cps-vip/robot-pcb/voltage_dividers.xlsx

Vout_max | 3 | V
Vin | 22 | V
R2 | 10000 | Ohm
R1 | 63333.33333 | Ohm
Vout_max | 3 | V
Vin | 5 | V
R2 | 10000 | Ohm
R1 | 6666.666667 | Ohm
Vout_max | 3 | V
Vin | 3.3 | V
R2 | 10000 | Ohm
R1 | 1000 | Ohm
R1 | 54900
R2 | 9310
Vin | 22
Vsense | 3.189845818
