cps-vip/robot-pcb/dcdc_eagle_3.3.kicad_sch

## KiCad design dcdc_eagle_3.3.kicad_sch (2026-04-16)

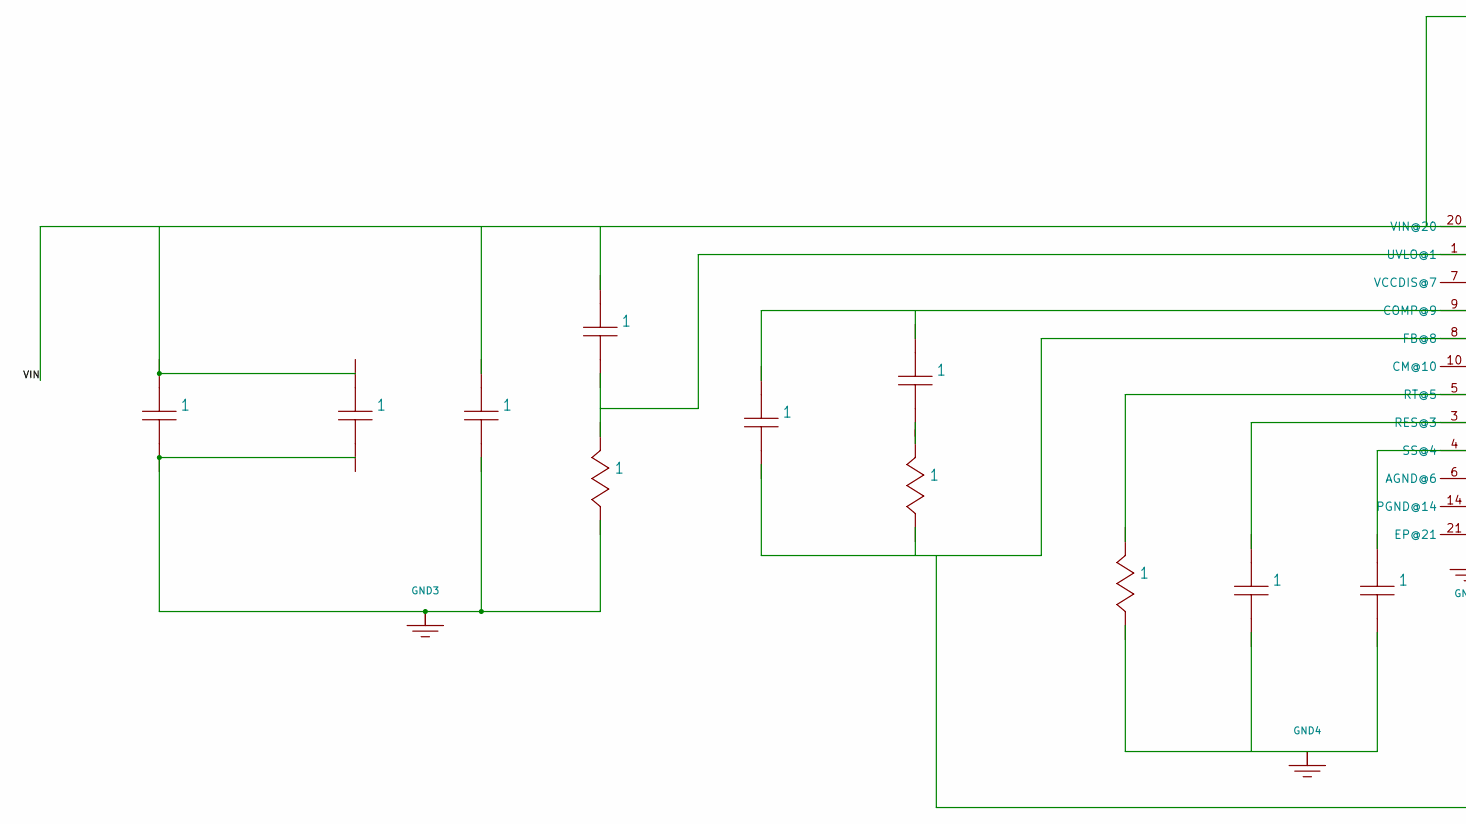
[picture p1: schematic dcdc_eagle_3.3.kicad_sch, part in row 1, column 1]

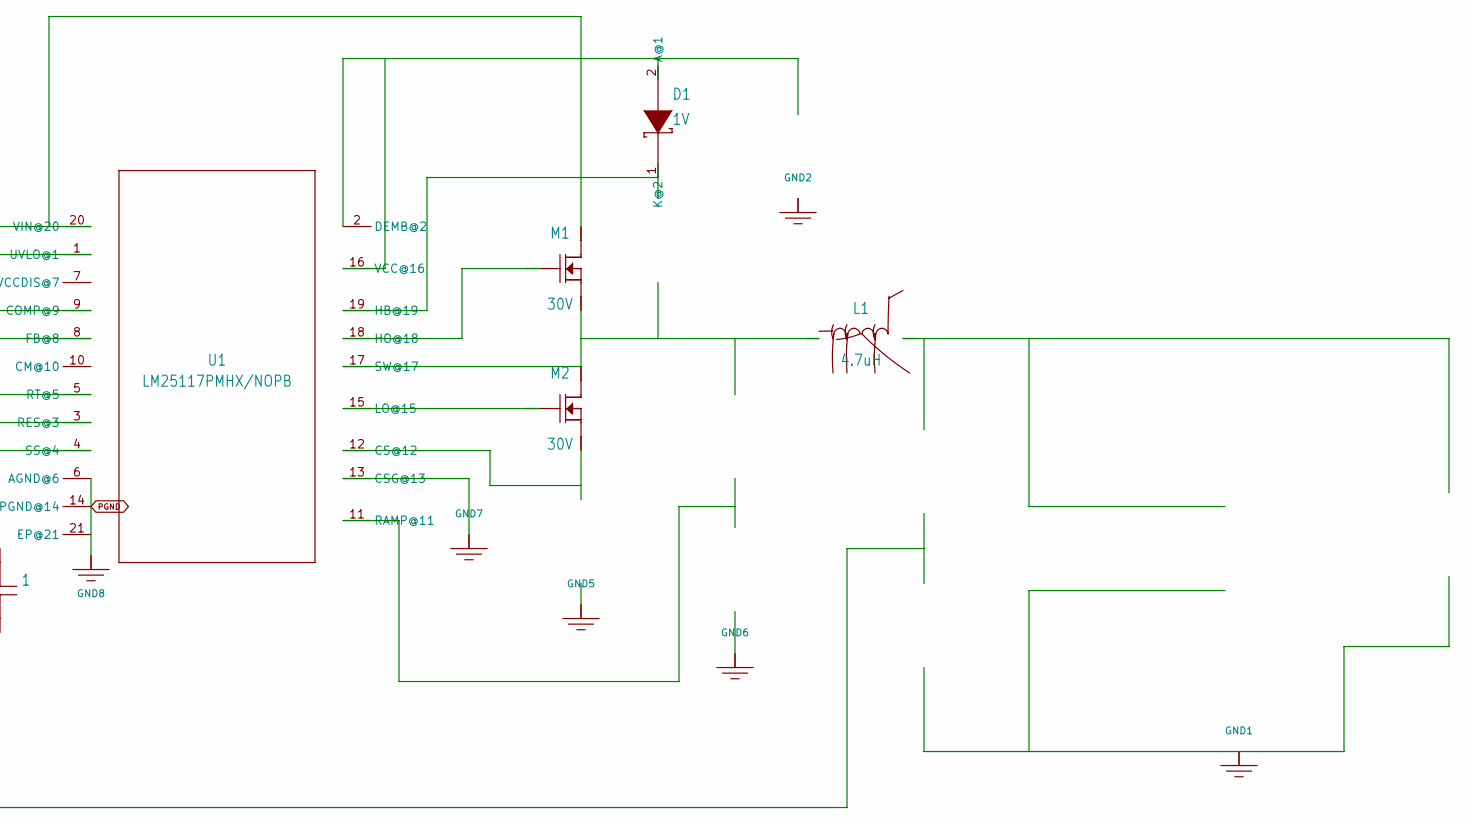
[picture p2: schematic dcdc_eagle_3.3.kicad_sch, part in row 1, column 2]

Parts:
1: 0805
D1: 1V; SOD-323
GND1, GND2, GND3, GND4, GND5, GND6, GND7, GND8: WB_GND
L1: 4.7uH; XAL6060
M1, M2: 30V; DQK0006C
U1: LM25117PMHX/NOPB; PWP0020A_N

Connections:
unnamed: 1.1 (1@1), 1.2 (2@2), U1.3 (RES@3), U1.4 (SS@4), U1.5 (RT@5), U1.9 (COMP@9)
unnamed: 1.2 (2@2), GND3.1, U1.8 (FB@8)
unnamed: GND7.1, U1.13 (CSG@13)
unnamed: M1.1 (Drain@1), M1.2 (Drain@2), M1.5 (Drain@3), M1.6 (Drain@4)
unnamed: M1.3 (Gate@5), U1.18 (HO@18)
unnamed: M1.4 (Source@6), M2.1 (Drain@1), M2.2 (Drain@2), M2.5 (Drain@3), M2.6 (Drain@4), U1.17 (SW@17)
unnamed: M2.3 (Gate@5), U1.15 (LO@15)
PGND: GND8.1, U1.6 (AGND@6), U1.14 (PGND@14)
VIN: U1.20 (VIN@20)
