cps-vip/robot-pcb/dcdc_reg.kicad_sch

## KiCad design dcdc_reg.kicad_sch (2026-05-31)

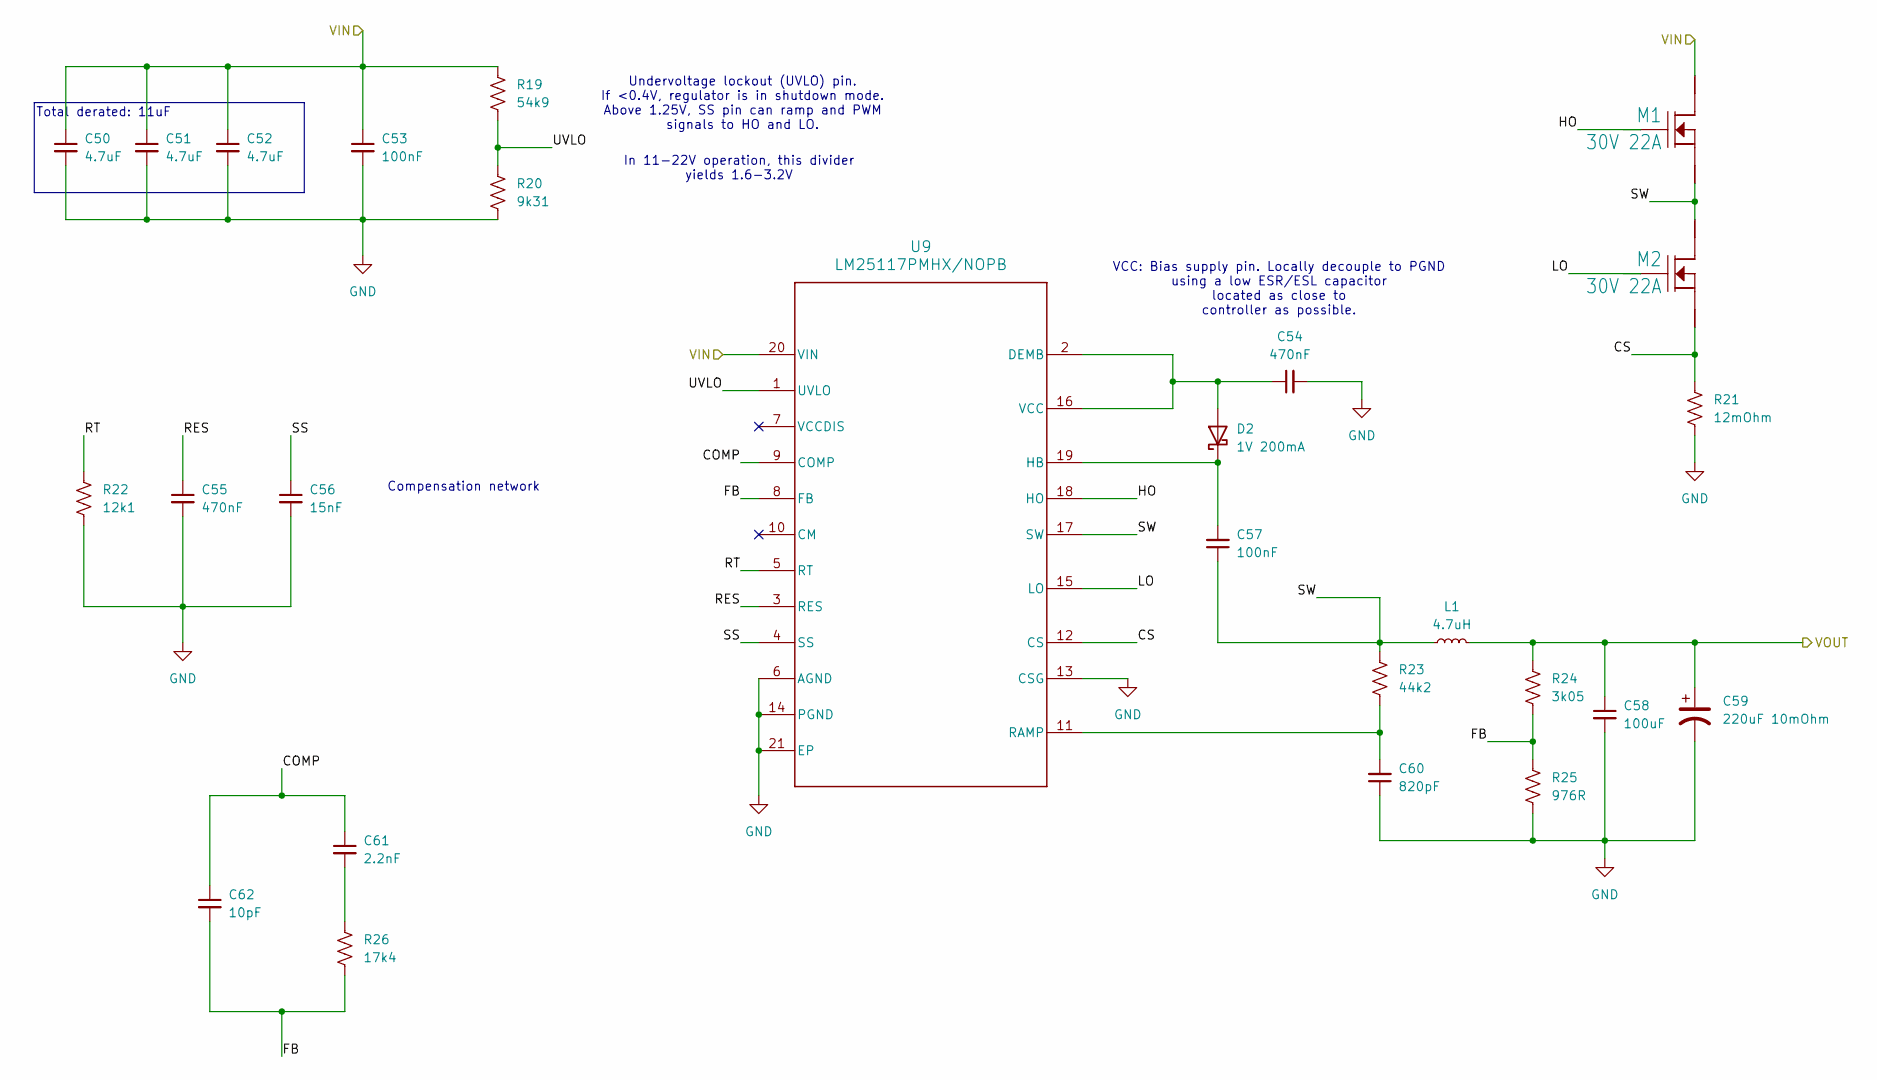
[picture p3: schematic dcdc_reg.kicad_sch]

Parts:
C50, C51, C52: 4.7uF
C53, C57: 100nF
C54, C55: 470nF
C56: 15nF
C58: 100uF
C59: 220uF 10mOhm
C60: 820pF
C61: 2.2nF
C62: 10pF
D2: 1V 200mA
L1: 4.7uH
M1, M2: 30V 22A; DQK0006C
R19: 54k9
R20: 9k31
R21: 12mOhm
R22: 12k1
R23: 44k2
R24: 3k05
R25: 976R
R26: 17k4
U9: LM25117PMHX/NOPB; PWP0020A_N

Connections:
COMP: C61.1, C62.1, U9.9 (COMP)
CS: M2.4 (Source@6), R21.1, U9.12 (CS)
FB: C62.2, R24.2, R25.1, R26.2, U9.8 (FB)
GND: C50.2, C51.2, C52.2, C53.2, C54.2, C55.2, C56.2, C58.2, C59.2, C60.1, R20.2, R21.2, R22.2, R25.2, U9.6 (AGND), U9.13 (CSG), U9.14 (PGND), U9.21 (EP)
HO: M1.3 (Gate@5), U9.18 (HO)
LO: M2.3 (Gate@5), U9.15 (LO)
unnamed: C54.1, D2.2 (A), U9.2 (DEMB), U9.16 (VCC)
unnamed: C57.2, D2.1 (K), U9.19 (HB)
unnamed: C60.2, R23.2, U9.11 (RAMP)
unnamed: C61.2, R26.1
RES: C55.1, U9.3 (RES)
RT: R22.1, U9.5 (RT)
SS: C56.1, U9.4 (SS)
SW: C57.1, L1.1, M1.4 (Source@6), M2.1 (Drain@1), M2.2 (Drain@2), M2.5 (Drain@3), M2.6 (Drain@4), R23.1, U9.17 (SW)
UVLO: R19.2, R20.1, U9.1 (UVLO)
VIN: C50.1, C51.1, C52.1, C53.1, M1.1 (Drain@1), M1.2 (Drain@2), M1.5 (Drain@3), M1.6 (Drain@4), R19.1, U9.20 (VIN)
VOUT: C58.1, C59.1, L1.2, R24.1

Notes on the sheet:
Compensation network
Undervoltage lockout (UVLO) pin. If <0.4V, regulator is in shutdown mode. Above 1.25V, SS pin can ramp and PWM signals to HO and LO.
VCC: Bias supply pin. Locally decouple to PGND using a low ESR/ESL capacitor located as close to controller as possible.
In 11-22V operation, this divider yields 1.6-3.2V
Total derated: 11uF
