cps-vip/robot-pcb/dcdc_reg_5v_6a.kicad_sch

## KiCad design dcdc_reg_5v_6a.kicad_sch (2026-05-31)

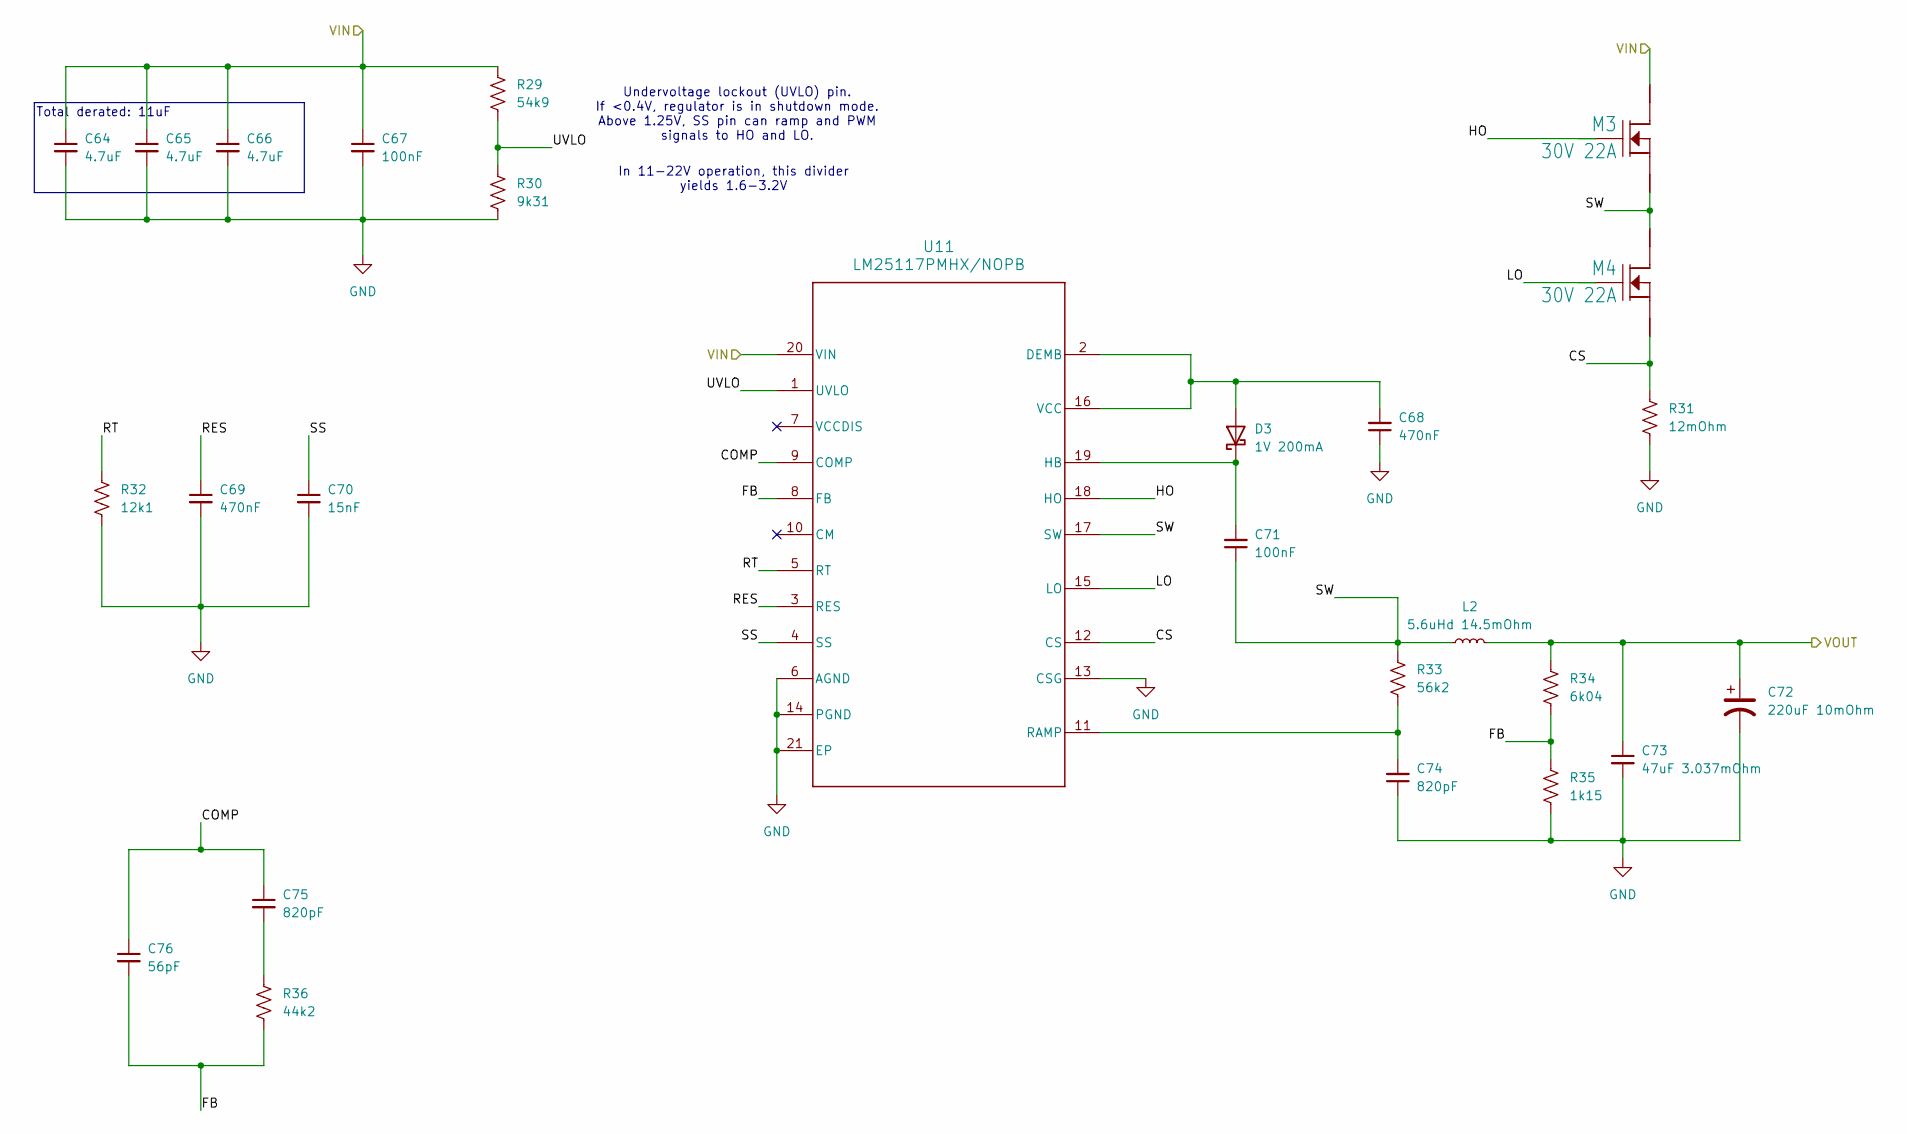
[picture p4: schematic dcdc_reg_5v_6a.kicad_sch]

Parts:
C64, C65, C66: 4.7uF
C67, C71: 100nF
C68, C69: 470nF
C70: 15nF
C72: 220uF 10mOhm
C73: 47uF 3.037mOhm
C74, C75: 820pF
C76: 56pF
D3: 1V 200mA
L2: 5.6uHd 14.5mOhm
M3, M4: 30V 22A; DQK0006C
R29: 54k9
R30: 9k31
R31: 12mOhm
R32: 12k1
R33: 56k2
R34: 6k04
R35: 1k15
R36: 44k2
U11: LM25117PMHX/NOPB; PWP0020A_N

Connections:
COMP: C75.1, C76.1, U11.9 (COMP)
CS: M4.4 (Source@6), R31.1, U11.12 (CS)
FB: C76.2, R34.2, R35.1, R36.2, U11.8 (FB)
GND: C64.2, C65.2, C66.2, C67.2, C68.1, C69.2, C70.2, C72.2, C73.2, C74.1, R30.2, R31.2, R32.2, R35.2, U11.6 (AGND), U11.13 (CSG), U11.14 (PGND), U11.21 (EP)
HO: M3.3 (Gate@5), U11.18 (HO)
LO: M4.3 (Gate@5), U11.15 (LO)
unnamed: C68.2, D3.2 (A), U11.2 (DEMB), U11.16 (VCC)
unnamed: C71.2, D3.1 (K), U11.19 (HB)
unnamed: C74.2, R33.2, U11.11 (RAMP)
unnamed: C75.2, R36.1
RES: C69.1, U11.3 (RES)
RT: R32.1, U11.5 (RT)
SS: C70.1, U11.4 (SS)
SW: C71.1, L2.1, M3.4 (Source@6), M4.1 (Drain@1), M4.2 (Drain@2), M4.5 (Drain@3), M4.6 (Drain@4), R33.1, U11.17 (SW)
UVLO: R29.2, R30.1, U11.1 (UVLO)
VIN: C64.1, C65.1, C66.1, C67.1, M3.1 (Drain@1), M3.2 (Drain@2), M3.5 (Drain@3), M3.6 (Drain@4), R29.1, U11.20 (VIN)
VOUT: C72.1, C73.1, L2.2, R34.1

Notes on the sheet:
Total derated: 11uF
In 11-22V operation, this divider yields 1.6-3.2V
Undervoltage lockout (UVLO) pin. If <0.4V, regulator is in shutdown mode. Above 1.25V, SS pin can ramp and PWM signals to HO and LO.
