cps-vip/robot-pcb/imu_module.kicad_sch

## KiCad design imu_module.kicad_sch (2026-04-16)

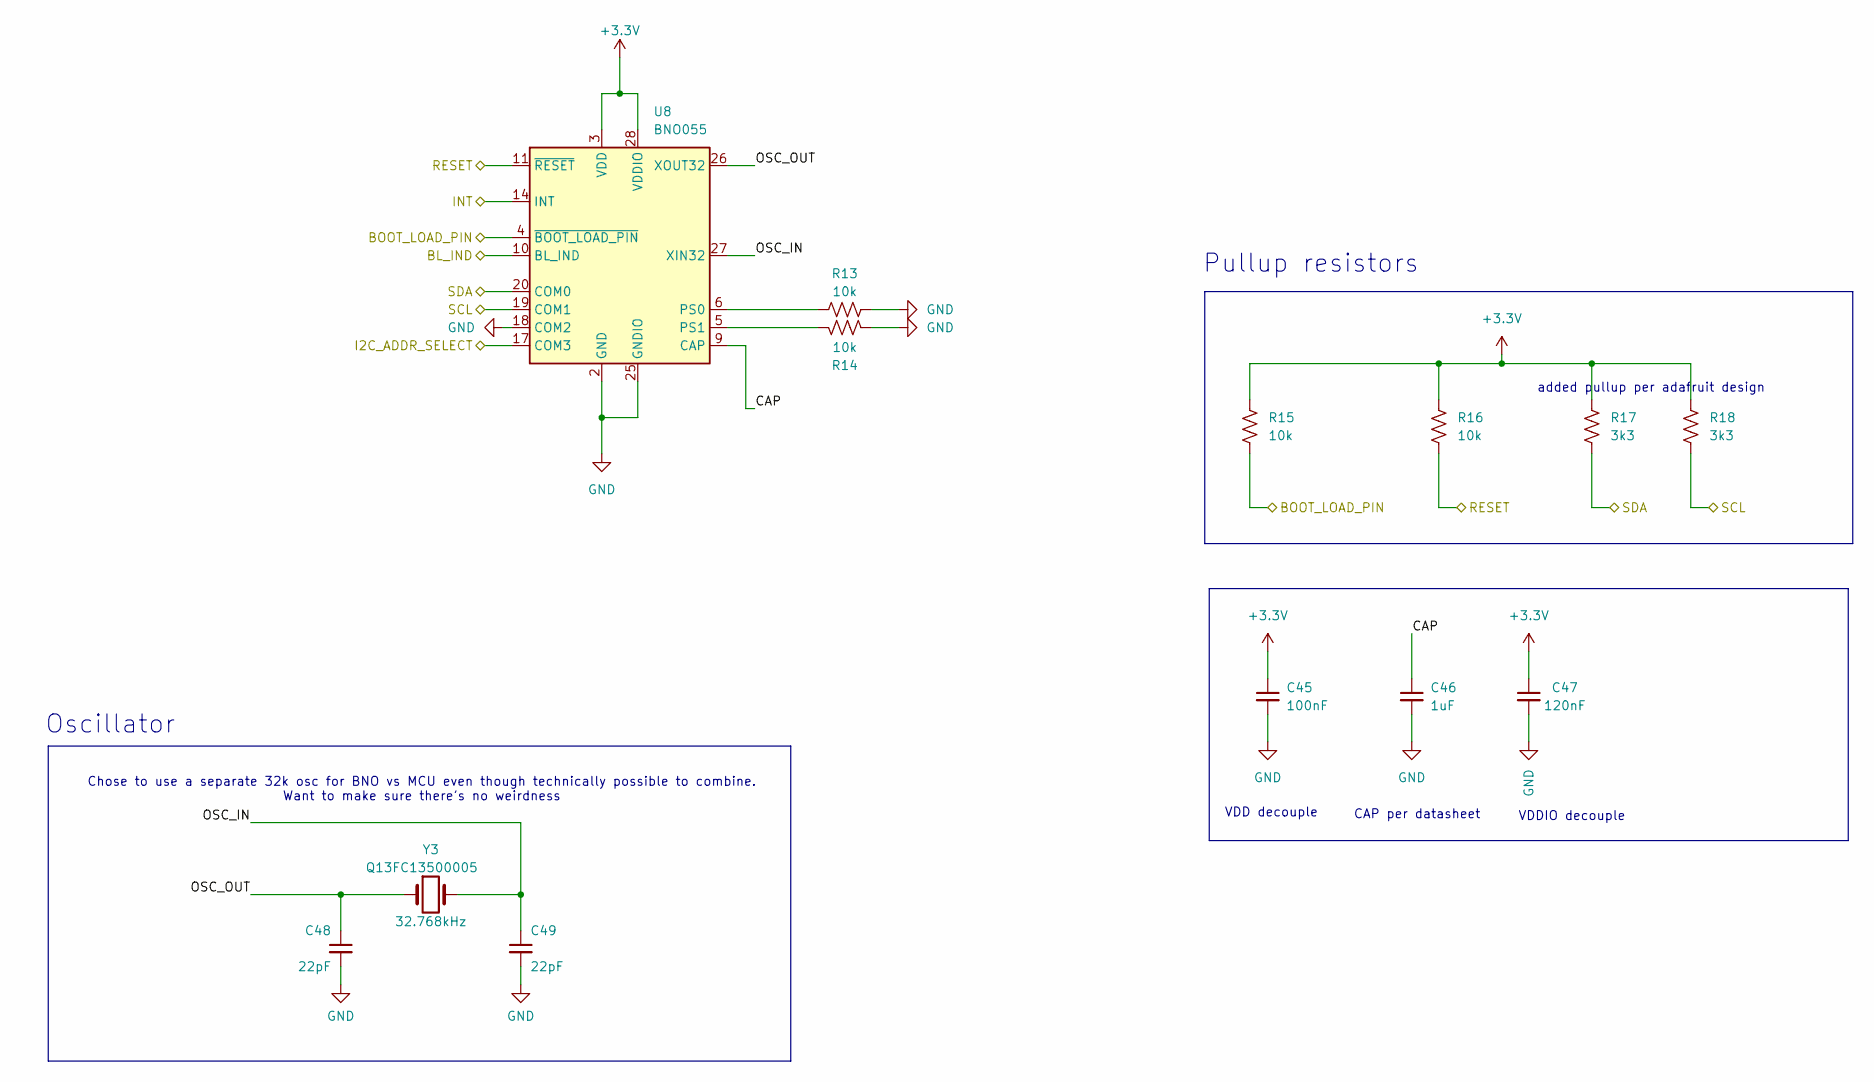
[picture p5: schematic imu_module.kicad_sch]

Parts:
C45: 100nF
C46: 1uF
C47: 120nF
C48, C49: 22pF; C_0402_1005Metric; LCSC C88877
R13, R14, R15, R16: 10k
R17, R18: 3k3
U8: BNO055; LGA-28_5.2x3.8mm_P0.5mm
Y3: Q13FC13500005; Crystal_SMD_3215-2Pin_3.2x1.5mm; LCSC C841881

Connections:
+3.3V: C45.1, C47.1, R15.1, R16.1, R17.1, R18.1, U8.3 (VDD), U8.28 (VDDIO)
BL_IND: U8.10 (BL_IND)
BOOT_LOAD_PIN: R15.2, U8.4 (~BOOT_LOAD_PIN)
CAP: C46.1, U8.9 (CAP)
GND: C45.2, C46.2, C47.2, C48.2, C49.2, R13.2, R14.2, U8.2 (GND), U8.18 (COM2), U8.25 (GNDIO)
I2C_ADDR_SELECT: U8.17 (COM3)
INT: U8.14 (INT)
unnamed: R13.1, U8.6 (PS0)
unnamed: R14.1, U8.5 (PS1)
OSC_IN: C49.1, U8.27 (XIN32), Y3.2
OSC_OUT: C48.1, U8.26 (XOUT32), Y3.1
RESET: R16.2, U8.11 (~RESET)
SCL: R18.2, U8.19 (COM1)
SDA: R17.2, U8.20 (COM0)

Notes on the sheet:
VDD decouple
Oscillator
VDDIO decouple
CAP per datasheet
added pullup per adafruit design
Pullup resistors
Chose to use a separate 32k osc for BNO vs MCU even though technically possible to combine. Want to make sure there's no weirdness
