cps-vip/robot-pcb/motor_driver.kicad_sch

## KiCad design motor_driver.kicad_sch (2026-05-31)

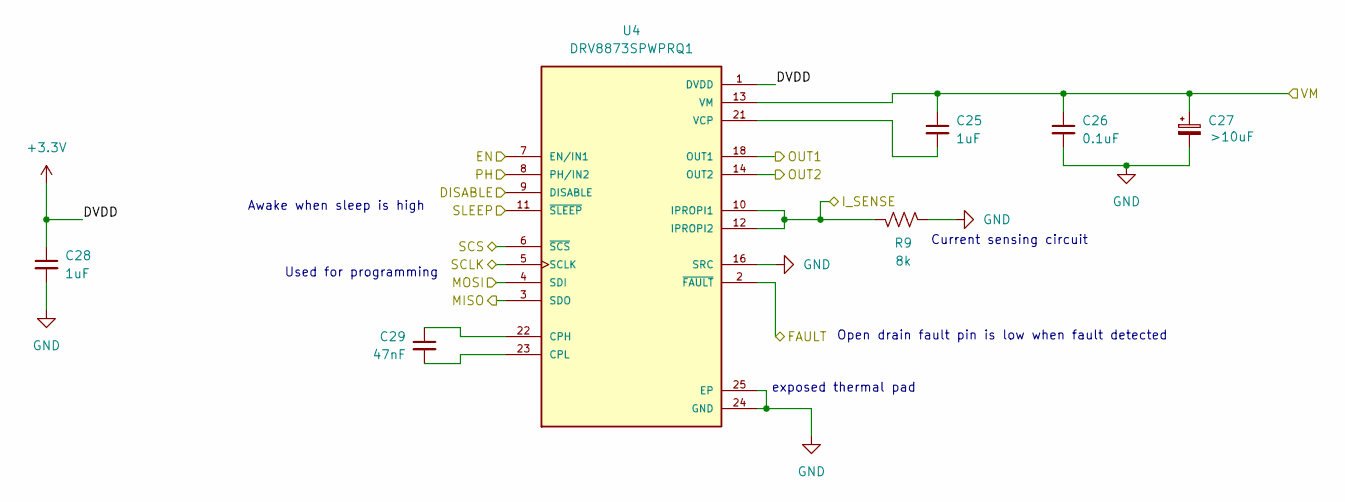
[picture p6: schematic motor_driver.kicad_sch]

Parts:
C25, C28: 1uF
C26: 0.1uF
C27: >10uF
C29: 47nF
R9: 8k
U4: DRV8873SPWPRQ1; IC_DRV8873SPWPRQ1; PARTREV A

Connections:
+3.3V: C28.1, U4.1 (DVDD)
DISABLE: U4.9 (DISABLE)
EN: U4.7 (EN/IN1)
FAULT: U4.2 (~FAULT)
GND: C26.2, C27.2, C28.2, R9.2, U4.16 (SRC), U4.17 (SRC), U4.24 (GND), U4.25 (EP), U4.25.1 (EP), U4.25.2 (EP), U4.25.3 (EP), U4.25.4 (EP), U4.25.5 (EP), U4.25.6 (EP), U4.25.7 (EP), U4.25.8 (EP), U4.25.9 (EP), U4.25.10 (EP), U4.25.11 (EP), U4.25.12 (EP), U4.25.13 (EP), U4.25.14 (EP), U4.25.15 (EP), U4.25.16 (EP), U4.25.17 (EP), U4.25.18 (EP)
I_SENSE: R9.1, U4.10 (IPROPI1), U4.12 (IPROPI2)
MISO: U4.3 (SDO)
MOSI: U4.4 (SDI)
unnamed: C25.2, U4.21 (VCP)
unnamed: C29.1, U4.22 (CPH)
unnamed: C29.2, U4.23 (CPL)
OUT1: U4.18 (OUT1), U4.19 (OUT1)
OUT2: U4.14 (OUT2), U4.15 (OUT2)
PH: U4.8 (PH/IN2)
SCLK: U4.5 (SCLK)
SCS: U4.6 (~SCS)
SLEEP: U4.11 (~SLEEP)
VM: C25.1, C26.1, C27.1, U4.13 (VM), U4.20 (VM)

Notes on the sheet:
Current sensing circuit
Open drain fault pin is low when fault detected
Awake when sleep is high
Used for programming
exposed thermal pad
