cps-vip/robot-pcb/robot.kicad_sch

## KiCad design robot.kicad_sch (2026-05-31)

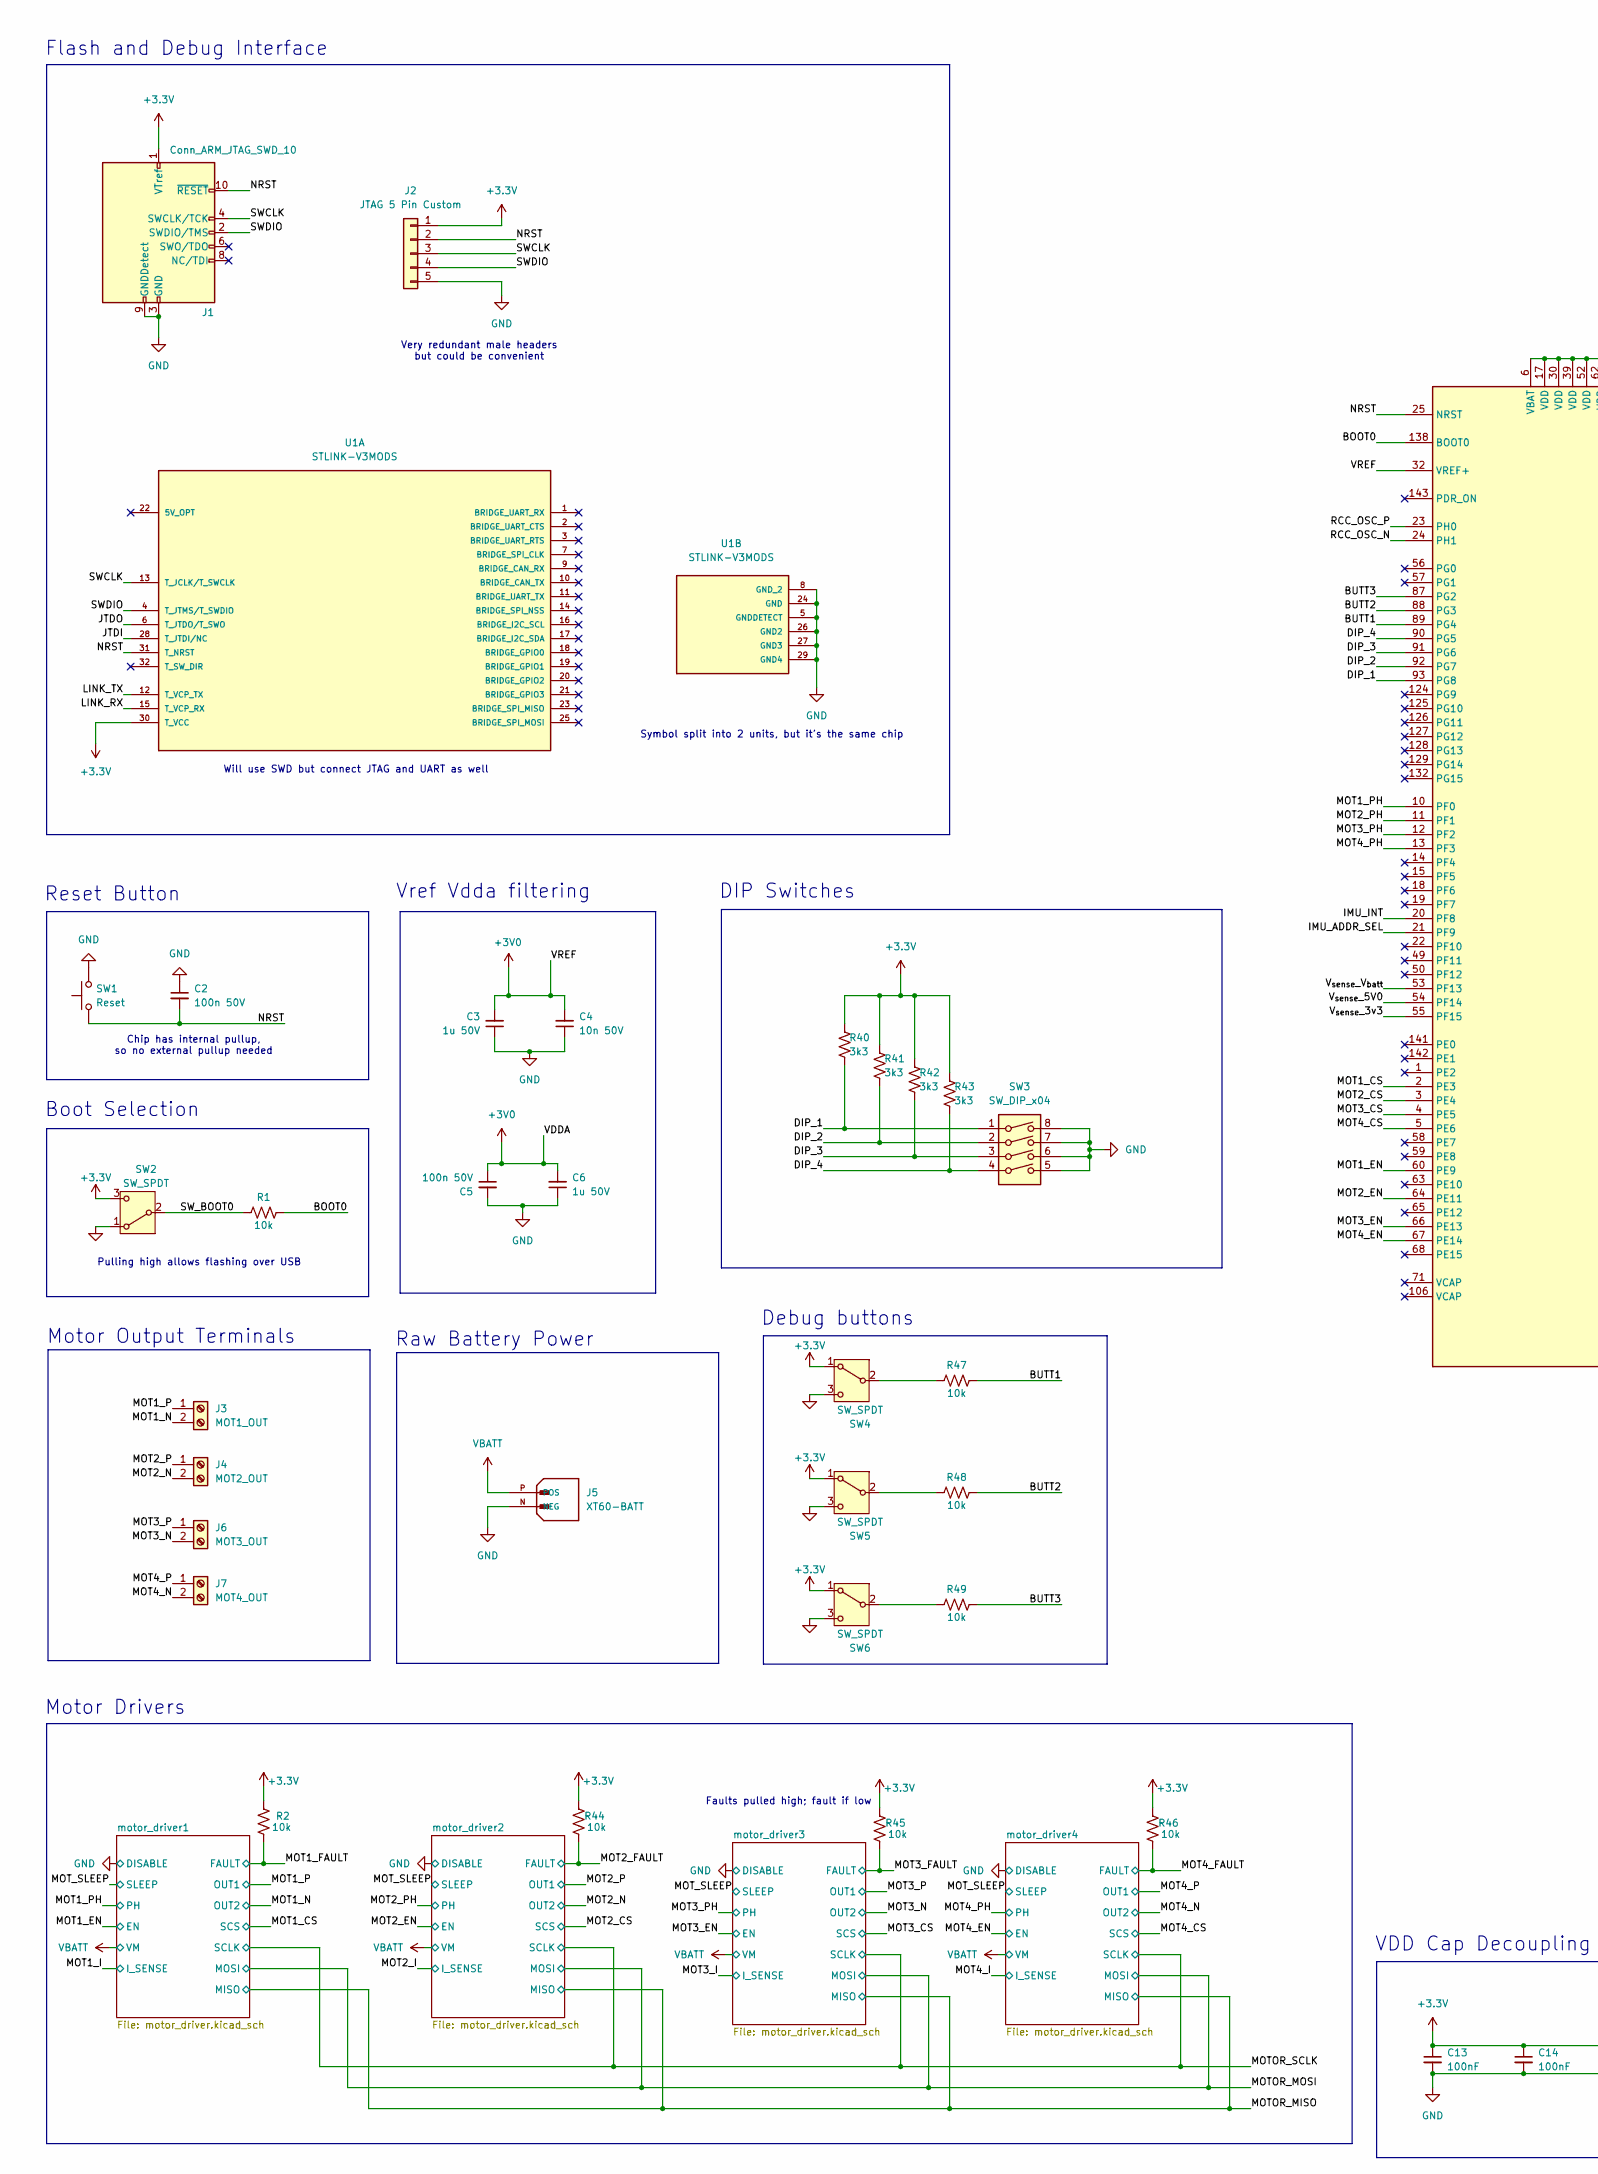
[picture p7: schematic robot.kicad_sch, part in row 1, column 1]

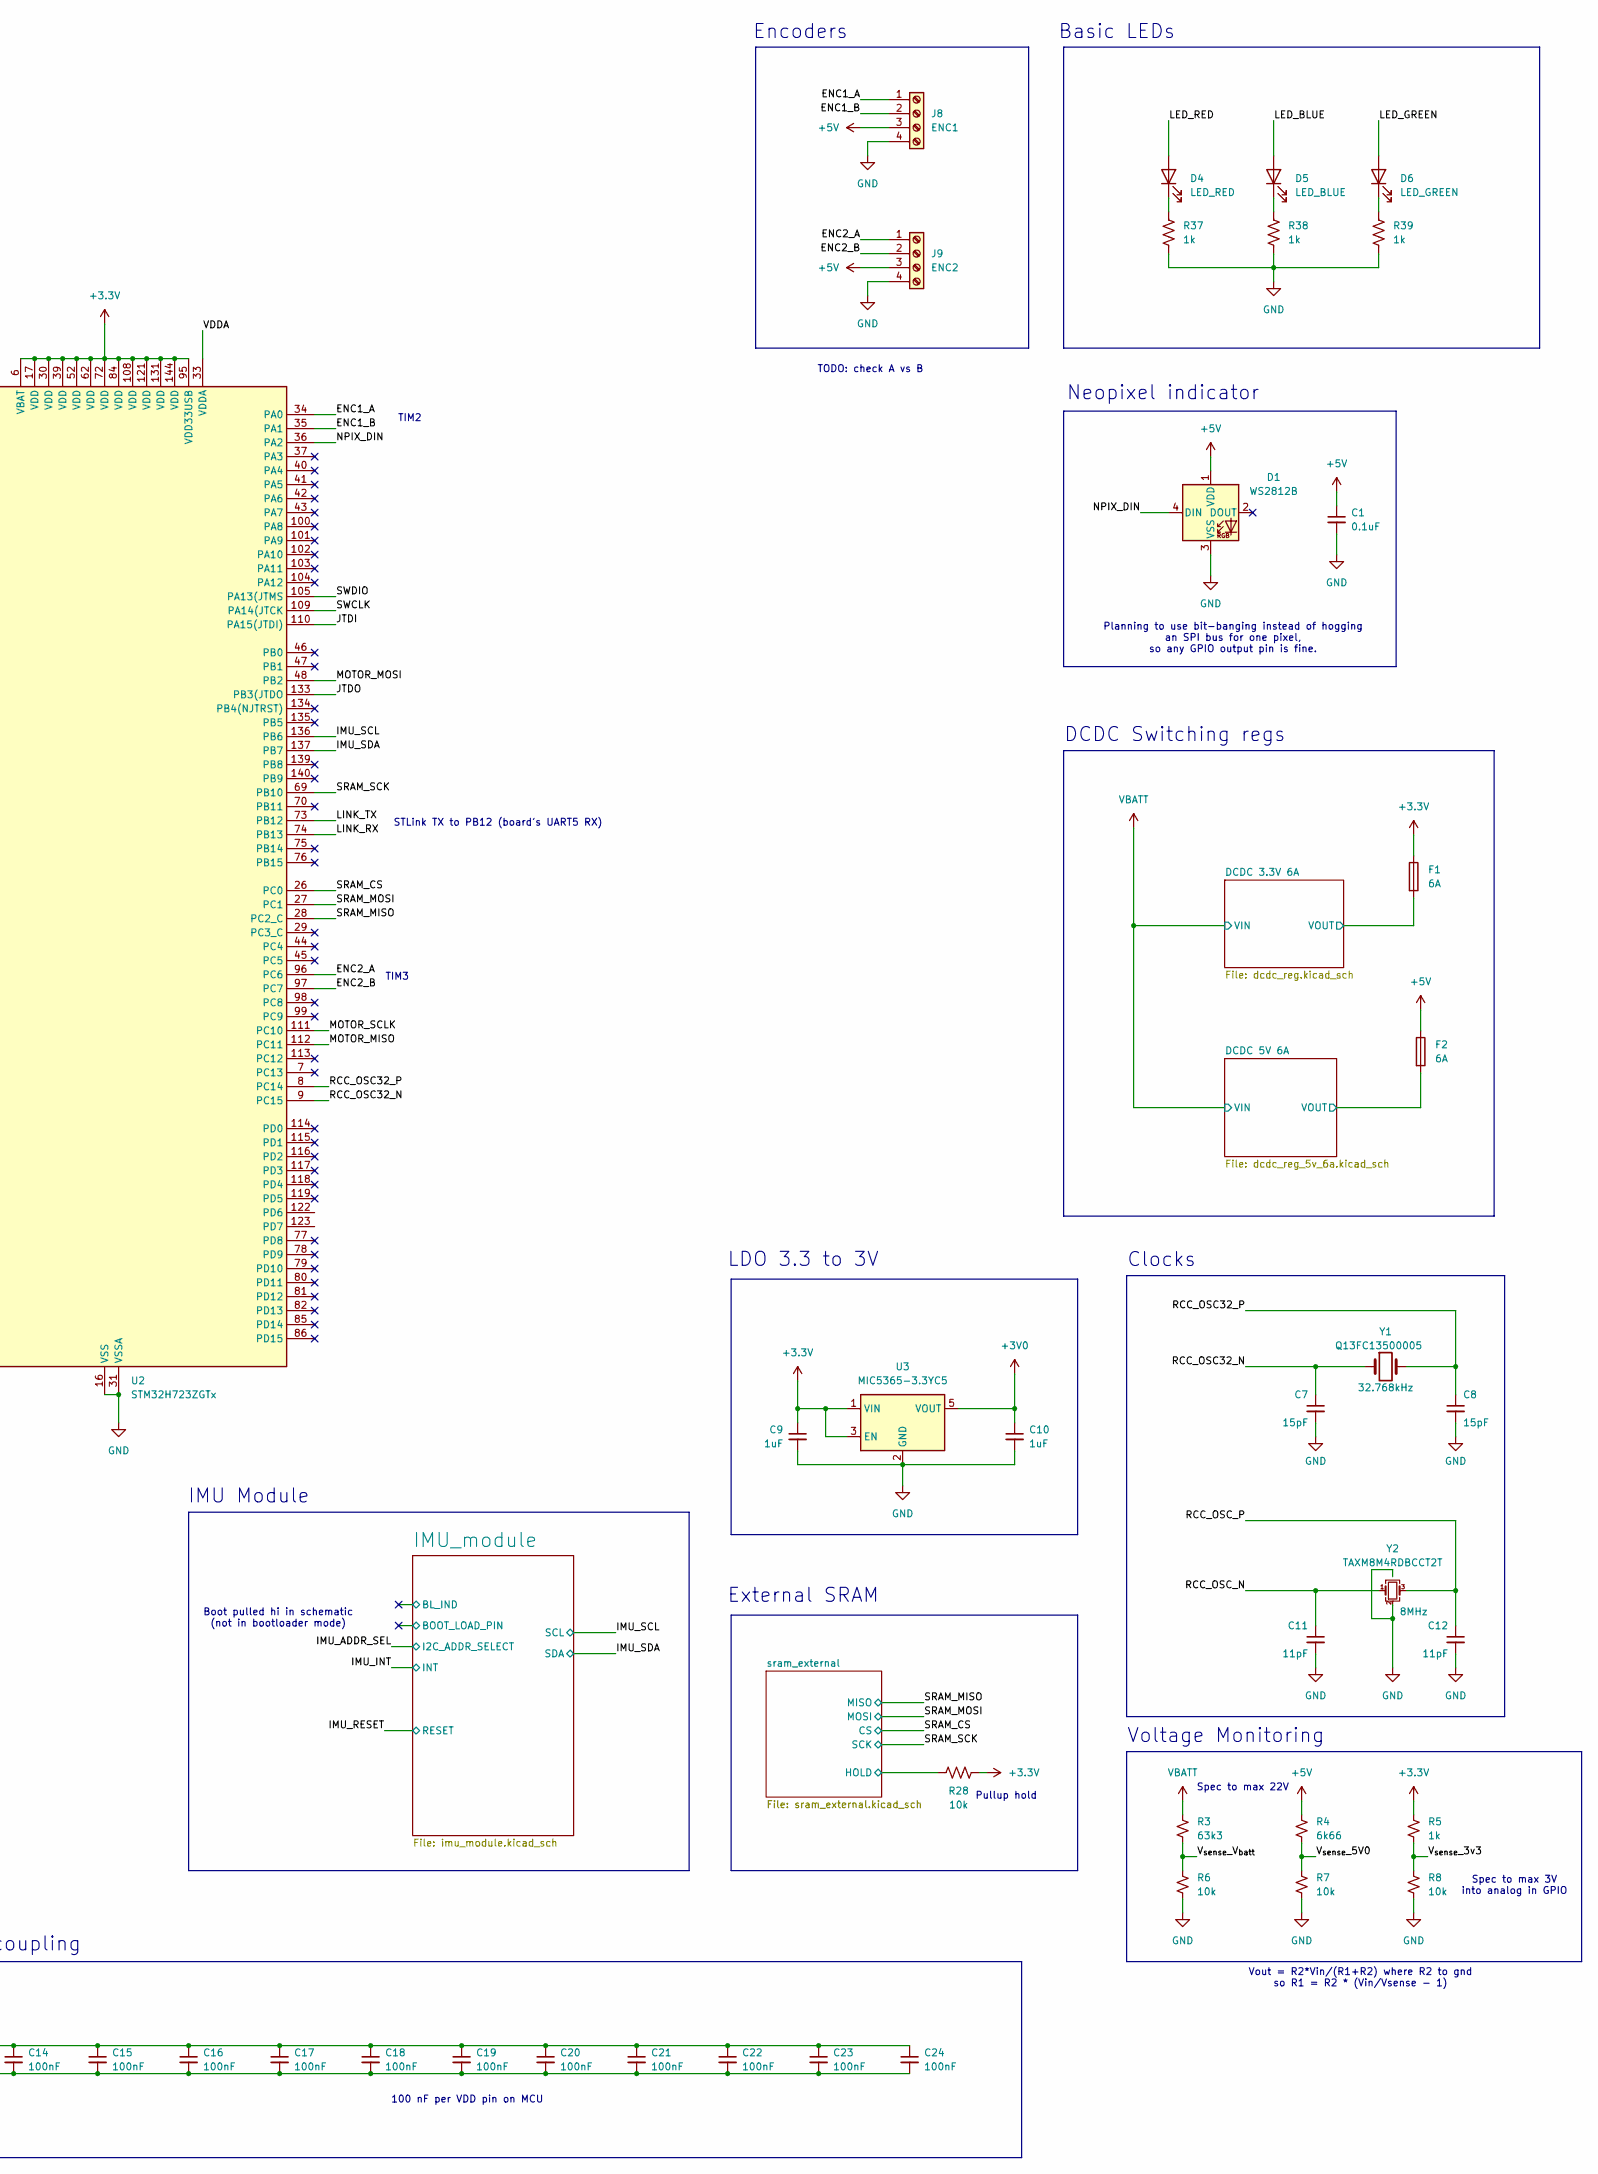
[picture p8: schematic robot.kicad_sch, part in row 1, column 2]

Parts:
C1: 0.1uF
C2, C5: 100n 50V
C3, C6: 1u 50V
C4: 10n 50V
C7, C8: 15pF; C_0402_1005Metric; LCSC C88877
C9, C10: 1uF
C11, C12: 11pF; C_0402_1005Metric; LCSC C161525
C13, C14, C15, C16, C17, C18, C19, C20, C21, C22, C23, C24: 100nF
D1: WS2812B; LED_WS2812B_PLCC4_5.0x5.0mm_P3.2mm
D4: LED_RED
D5: LED_BLUE
D6: LED_GREEN
F1, F2: 6A
J1: Conn_ARM_JTAG_SWD_10
J2: JTAG 5 Pin Custom
J3: MOT1_OUT
J4: MOT2_OUT
J5: XT60-BATT; AMASS_XT60-M; PARTREV V1.2
J6: MOT3_OUT
J7: MOT4_OUT
J8: ENC1
J9: ENC2
R1, R2, R28, R44, R45, R46, R47, R48, R49: 10k
R3: 63k3; R_0402_1005Metric; LCSC C270653
R4: 6k66; R_0402_1005Metric; LCSC C25867
R5: 1k; R_0402_1005Metric; LCSC C82294
R6, R7, R8: 10k; R_0402_1005Metric; LCSC C11702
R37, R38, R39: 1k
R40, R41, R42, R43: 3k3
SW1: Reset; SW_PUSH-12mm
SW2, SW4, SW5, SW6: SW_SPDT; SW_PUSH-12mm
SW3: SW_DIP_x04
U1: STLINK-V3MODS; MODULE_STLINK-V3MODS; PARTREV 1
U2: STM32H723ZGTx; LQFP-144_20x20mm_P0.5mm
U3: MIC5365-3.3YC5; SOT-353_SC-70-5
Y1: Q13FC13500005; Crystal_SMD_3215-2Pin_3.2x1.5mm; LCSC C841881
Y2: TAXM8M4RDBCCT2T; Crystal_SMD_3225-4Pin_3.2x2.5mm; LCSC C400090

Connections:
+3.3V: C9.1, C13.1, C14.1, C15.1, C16.1, C17.1, C18.1, C19.1, C20.1, C21.1, C22.1, C23.1, C24.1, F1.1, J1.1 (VTref), J2.1, R2.2, R5.1, R28.1, R40.1, R41.1, R42.1, R43.1, R44.2, R45.2, R46.2, SW2.3 (C), SW4.1 (A), SW5.1 (A), SW6.1 (A), U1.30 (T_VCC), U2.6 (VBAT), U2.17 (VDD), U2.30 (VDD), U2.39 (VDD), U2.52 (VDD), U2.62 (VDD), U2.72 (VDD), U2.84 (VDD), U2.95 (VDD33USB), U2.108 (VDD), U2.121 (VDD), U2.131 (VDD), U2.144 (VDD), U3.1 (VIN), U3.3 (EN)
+3V0: C3.2, C4.2, C5.1, C6.2, C10.1, U2.32 (VREF+), U2.33 (VDDA), U3.5 (VOUT)
+5V: C1.1, D1.1 (VDD), F2.1, J8.3, J9.3, R4.1
BOOT0: R1.2, U2.138 (BOOT0)
BUTT1: R47.2, U2.89 (PG4)
BUTT2: R48.2, U2.88 (PG3)
BUTT3: R49.2, U2.87 (PG2)
DIP_1: R40.2, SW3.1, U2.93 (PG8)
DIP_2: R41.2, SW3.2, U2.92 (PG7)
DIP_3: R42.2, SW3.3, U2.91 (PG6)
DIP_4: R43.2, SW3.4, U2.90 (PG5)
ENC1_A: J8.1, U2.34 (PA0)
ENC1_B: J8.2, U2.35 (PA1)
ENC2_A: J9.1, U2.96 (PC6)
ENC2_B: J9.2, U2.97 (PC7)
GND: C1.2, C2.1, C3.1, C4.1, C5.2, C6.1, C7.2, C8.2, C9.2, C10.2, C11.2, C12.2, C13.2, C14.2, C15.2, C16.2, C17.2, C18.2, C19.2, C20.2, C21.2, C22.2, C23.2, C24.2, D1.3 (VSS), J1.3 (GND), J1.5 (GND), J1.9 (GNDDetect), J2.5, J5.N (NEG), J8.4, J9.4, R6.2, R7.2, R8.2, R37.2, R38.2, R39.2, SW1.2, SW2.1 (A), SW3.5, SW3.6, SW3.7, SW3.8, SW4.3 (C), SW5.3 (C), SW6.3 (C), U1.5 (GNDDETECT), U1.8 (GND_2), U1.24 (GND), U1.26 (GND2), U1.27 (GND3), U1.29 (GND4), U2.16 (VSS), U2.31 (VSSA), U2.38 (VSS), U2.51 (VSS), U2.61 (VSS), U2.83 (VSS), U2.94 (VSS), U2.107 (VSS), U2.120 (VSS), U2.130 (VSS), U3.2 (GND), Y2.2 (G), Y2.4 (G)
HOLD: R28.2
IMU_ADDR_SEL: U2.21 (PF9)
IMU_INT: U2.20 (PF8)
IMU_SCL: U2.136 (PB6)
IMU_SDA: U2.137 (PB7)
JTDI: U1.28 (T_JTDI/NC), U2.110 (PA15(JTDI))
JTDO: U1.6 (T_JTDO/T_SWO), U2.133 (PB3(JTDO)
LED_BLUE: D5.2 (A)
LED_GREEN: D6.2 (A)
LED_RED: D4.2 (A)
LINK_RX: U1.15 (T_VCP_RX), U2.74 (PB13)
LINK_TX: U1.12 (T_VCP_TX), U2.73 (PB12)
MOT1_CS: U2.2 (PE3)
MOT1_EN: U2.60 (PE9)
MOT1_FAULT: R2.1
MOT1_N: J3.2
MOT1_P: J3.1
MOT1_PH: U2.10 (PF0)
MOT2_CS: U2.3 (PE4)
MOT2_EN: U2.64 (PE11)
MOT2_FAULT: R44.1
MOT2_N: J4.2
MOT2_P: J4.1
MOT2_PH: U2.11 (PF1)
MOT3_CS: U2.4 (PE5)
MOT3_EN: U2.66 (PE13)
MOT3_FAULT: R45.1
MOT3_N: J6.2
MOT3_P: J6.1
MOT3_PH: U2.12 (PF2)
MOT4_CS: U2.5 (PE6)
MOT4_EN: U2.67 (PE14)
MOT4_FAULT: R46.1
MOT4_N: J7.2
MOT4_P: J7.1
MOT4_PH: U2.13 (PF3)
MOTOR_MISO: U2.112 (PC11)
MOTOR_MOSI: U2.48 (PB2)
MOTOR_SCLK: U2.111 (PC10)
NPIX_DIN: D1.4 (DIN), U2.36 (PA2)
NRST: C2.2, J1.10 (~RESET), J2.2, SW1.1, U1.31 (T_NRST), U2.25 (NRST)
unnamed: D4.1 (K), R37.1
unnamed: D5.1 (K), R38.1
unnamed: D6.1 (K), R39.1
unnamed: R47.1, SW4.2 (B)
unnamed: R48.1, SW5.2 (B)
unnamed: R49.1, SW6.2 (B)
RCC_OSC32_N: C7.1, U2.9 (PC15), Y1.1
RCC_OSC32_P: C8.1, U2.8 (PC14), Y1.2
RCC_OSC_N: C11.1, U2.24 (PH1), Y2.1
RCC_OSC_P: C12.1, U2.23 (PH0), Y2.3
SRAM_CS: U2.26 (PC0)
SRAM_MISO: U2.28 (PC2_C)
SRAM_MOSI: U2.27 (PC1)
SRAM_SCK: U2.69 (PB10)
SWCLK: J1.4 (SWCLK/TCK), J2.3, U1.13 (T_JCLK/T_SWCLK), U2.109 (PA14(JTCK)
SWDIO: J1.2 (SWDIO/TMS), J2.4, U1.4 (T_JTMS/T_SWDIO), U2.105 (PA13(JTMS)
SW_BOOT0: R1.1, SW2.2 (B)
VBATT: J5.P (POS), R3.1
VOUT: F1.2, F2.2
V_{sense}_3v3: R5.2, R8.1, U2.55 (PF15)
V_{sense}_5V0: R4.2, R7.1, U2.54 (PF14)
V_{sense}_V_{batt}: R3.2, R6.1, U2.53 (PF13)

Notes on the sheet:
Symbol split into 2 units, but it's the same chip
TODO: check A vs B
Pulling high allows flashing over USB
DCDC Switching regs
IMU Module
TIM3
Boot pulled hi in schematic (not in bootloader mode)
Boot Selection
Voltage Monitoring
Basic LEDs
VDD Cap Decoupling
100 nF per VDD pin on MCU
Spec to max 22V
Faults pulled high; fault if low
Spec to max 3V into analog in GPIO
Neopixel indicator
Flash and Debug Interface
Motor Output Terminals
Vout = R2*Vin/(R1+R2) where R2 to gnd so R1 = R2 * (Vin/Vsense - 1)
Planning to use bit-banging instead of hogging an SPI bus for one pixel, so any GPIO output pin is fine.
Clocks
Very redundant male headers but could be convenient
Motor Drivers
Raw Battery Power
External SRAM
Will use SWD but connect JTAG and UART as well
Pullup hold
Debug buttons
Vref Vdda filtering
Encoders
STLink TX to PB12 (board's UART5 RX)
TIM2
Reset Button
DIP Switches
Chip has internal pullup, so no external pullup needed
LDO 3.3 to 3V
