cps-vip/robot-pcb/sram_external.kicad_sch

## KiCad design sram_external.kicad_sch (2026-05-31)

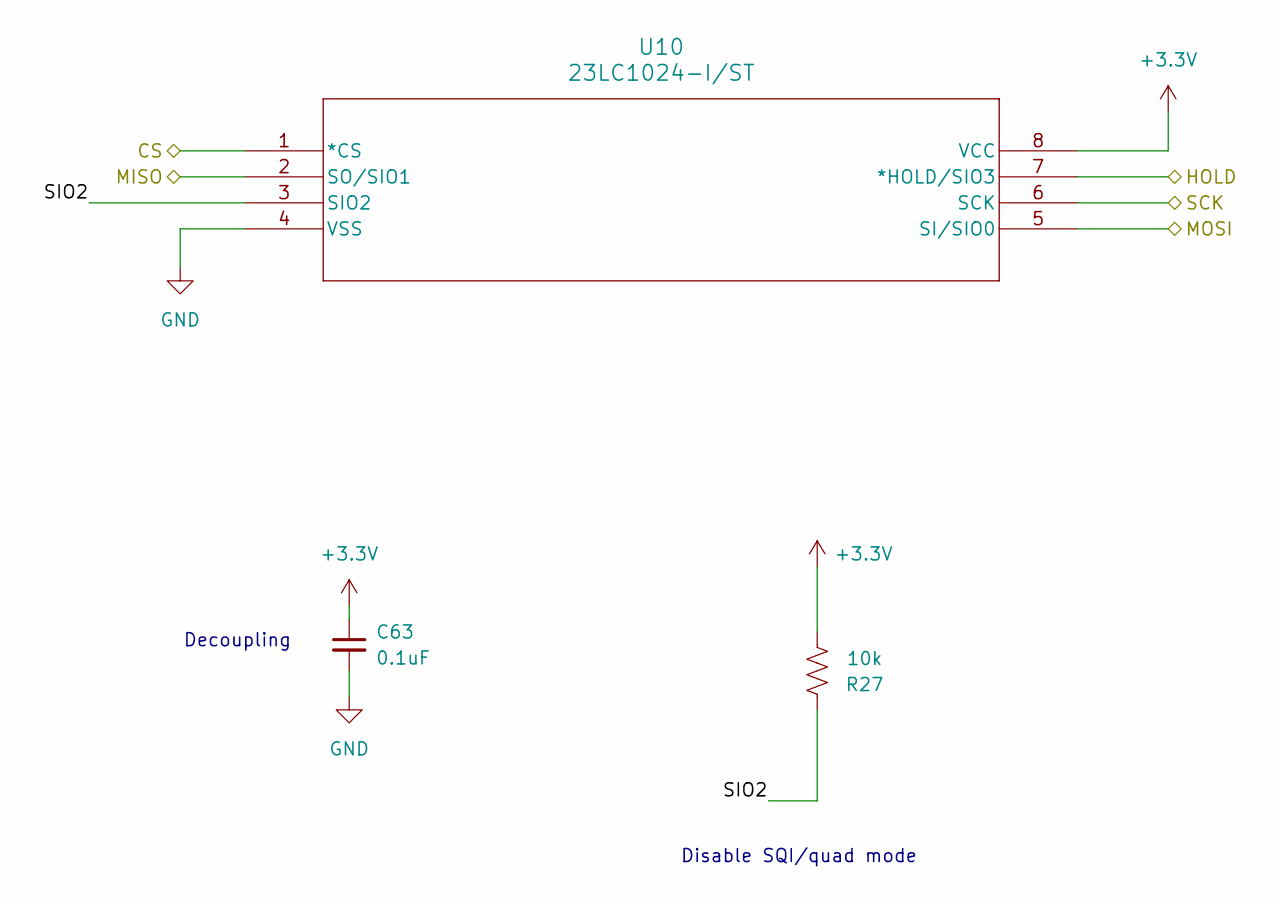
[picture p9: schematic sram_external.kicad_sch]

Parts:
C63: 0.1uF
R27: 10k
U10: 23LC1024-I/ST; TSSOP8_MC_MCH

Connections:
+3.3V: C63.1, R27.2, U10.8 (VCC)
CS: U10.1 (*CS)
GND: C63.2, U10.4 (VSS)
HOLD: U10.7 (*HOLD/SIO3)
MISO: U10.2 (SO/SIO1)
MOSI: U10.5 (SI/SIO0)
SCK: U10.6 (SCK)
SIO2: R27.1, U10.3 (SIO2)

Notes on the sheet:
Disable SQI/quad mode
Decoupling
