cps-vip/robot-pcb/cubemx/cubemx.ioc

Mcu.UserName=STM32H723ZGTx
PA0.GPIO_Label=ENC1_A
PA0.Signal=S_TIM2_CH1_ETR
PA1.GPIO_Label=ENC1_B
PA1.Signal=S_TIM2_CH2
PA13(JTMS/SWDIO).Signal=DEBUG_JTMS-SWDIO
PA14(JTCK/SWCLK).Signal=DEBUG_JTCK-SWCLK
PA15(JTDI).Signal=DEBUG_JTDI
PA2.GPIO_Label=Neopixel_data
PA2.Signal=GPIO_Output
PA5.Signal=SPI1_SCK
PA6.Signal=SPI1_MISO
PA7.Signal=SPI1_MOSI
PA9.Signal=SPI2_SCK
PB12.Signal=UART5_RX
PB13.Signal=UART5_TX
PB14.Signal=S_TIM12_CH1
PB15.Signal=S_TIM12_CH2
PB2.Signal=SPI3_MOSI
PB3(JTDO/TRACESWO).Signal=DEBUG_JTDO-SWO
PB6.Signal=I2C1_SCL
PB7.Signal=I2C1_SDA
PC0.GPIO_Label=SRAM_CS
PC0.Signal=GPIO_Output
PC1.Signal=SPI2_MOSI
PC10.Signal=SPI3_SCK
PC11.Signal=SPI3_MISO
PC14-OSC32_IN.Signal=RCC_OSC32_IN
PC15-OSC32_OUT.Signal=RCC_OSC32_OUT
PC2_C.Signal=SPI2_MISO
PC6.GPIO_Label=ENC2_A
PC6.Signal=S_TIM3_CH1
PC7.GPIO_Label=ENC2_B
PC7.Signal=S_TIM3_CH2
PD12.Signal=S_TIM4_CH1
PD13.Signal=S_TIM4_CH2
PD7.GPIO_Label=MOT_FAULT
PD7.Signal=GPIO_Input
PE11.GPIO_Label=MOT2_EN
PE11.Signal=S_TIM1_CH2
PE13.GPIO_Label=MOT3_EN
PE13.Signal=S_TIM1_CH3
PE14.GPIO_Label=MOT4_EN
PE14.Signal=S_TIM1_CH4
PE3.GPIO_Label=MOT1_CS
PE3.Signal=GPIO_Output
PE4.GPIO_Label=MOT2_CS
PE4.Signal=GPIO_Output
PE5.GPIO_Label=MOT3_CS
PE5.Signal=GPIO_Output
PE6.GPIO_Label=MOT4_CS
PE6.Signal=GPIO_Output
PE9.GPIO_Label=MOT1_EN
PE9.Signal=S_TIM1_CH1
PF0.GPIO_Label=MOT1_PH
PF0.Signal=GPIO_Output
PF1.GPIO_Label=MOT2_PH
PF1.Signal=GPIO_Output
PF11.Signal=TIM24_CH1
PF12.Signal=S_TIM24_CH2
PF13.Signal=GPIO_Analog
PF14.GPIO_Label=Vsense_5v
PF14.Signal=GPIO_Analog
PF15.GPIO_Label=Vsense_3v3
PF15.Signal=GPIO_Analog
PF2.GPIO_Label=MOT3_PH
PF2.Signal=GPIO_Output
PF3.Signal=GPIO_Output
PF8.GPIO_Label=IMU_INT
PF8.Signal=GPIO_Input
PF9.GPIO_Label=IMU_ADDR_SEL
PF9.Signal=GPIO_Output
PG12.Signal=TIM23_CH1
PG13.Signal=S_TIM23_CH2
PG2.GPIO_Label=BUTT3
PG2.Signal=GPIO_Input
PG3.GPIO_Label=BUTT2
PG3.Signal=GPIO_Input
PG4.GPIO_Label=BUTT1
PG4.Signal=GPIO_Input
PG5.GPIO_Label=DIP4
PG5.Signal=GPIO_Input
PG6.GPIO_Label=DIP3
PG6.Signal=GPIO_Input
PG7.GPIO_Label=DIP2
PG7.Signal=GPIO_Input
PG8.GPIO_Label=DIP1
PG8.Signal=GPIO_Input
PH0-OSC_IN.Signal=RCC_OSC_IN
PH1-OSC_OUT.Signal=RCC_OSC_OUT
