cps-vip/robot-pcb/(commit log)

2026-04-16 Check in revision 1
    [5V6A_DCDC.csv, dcdc_eagle_3.3.kicad_sch, dcdc_reg.kicad_sch, dcdc_reg_5v_6a.kicad_sch, imu_module.kicad_sch, motor_driver.kicad_sch, robot.kicad_sch, sram_external.kicad_sch]
2026-04-16 Add dip switch, buttons, leds, indiv mot fault pins
    [robot.kicad_sch]
2026-05-31 Revise following review 1
    [dcdc_reg.kicad_sch, dcdc_reg_5v_6a.kicad_sch, motor_driver.kicad_sch, robot.kicad_sch, sram_external.kicad_sch]
